anovosad/ambika-controller/hw/scheme.pdf

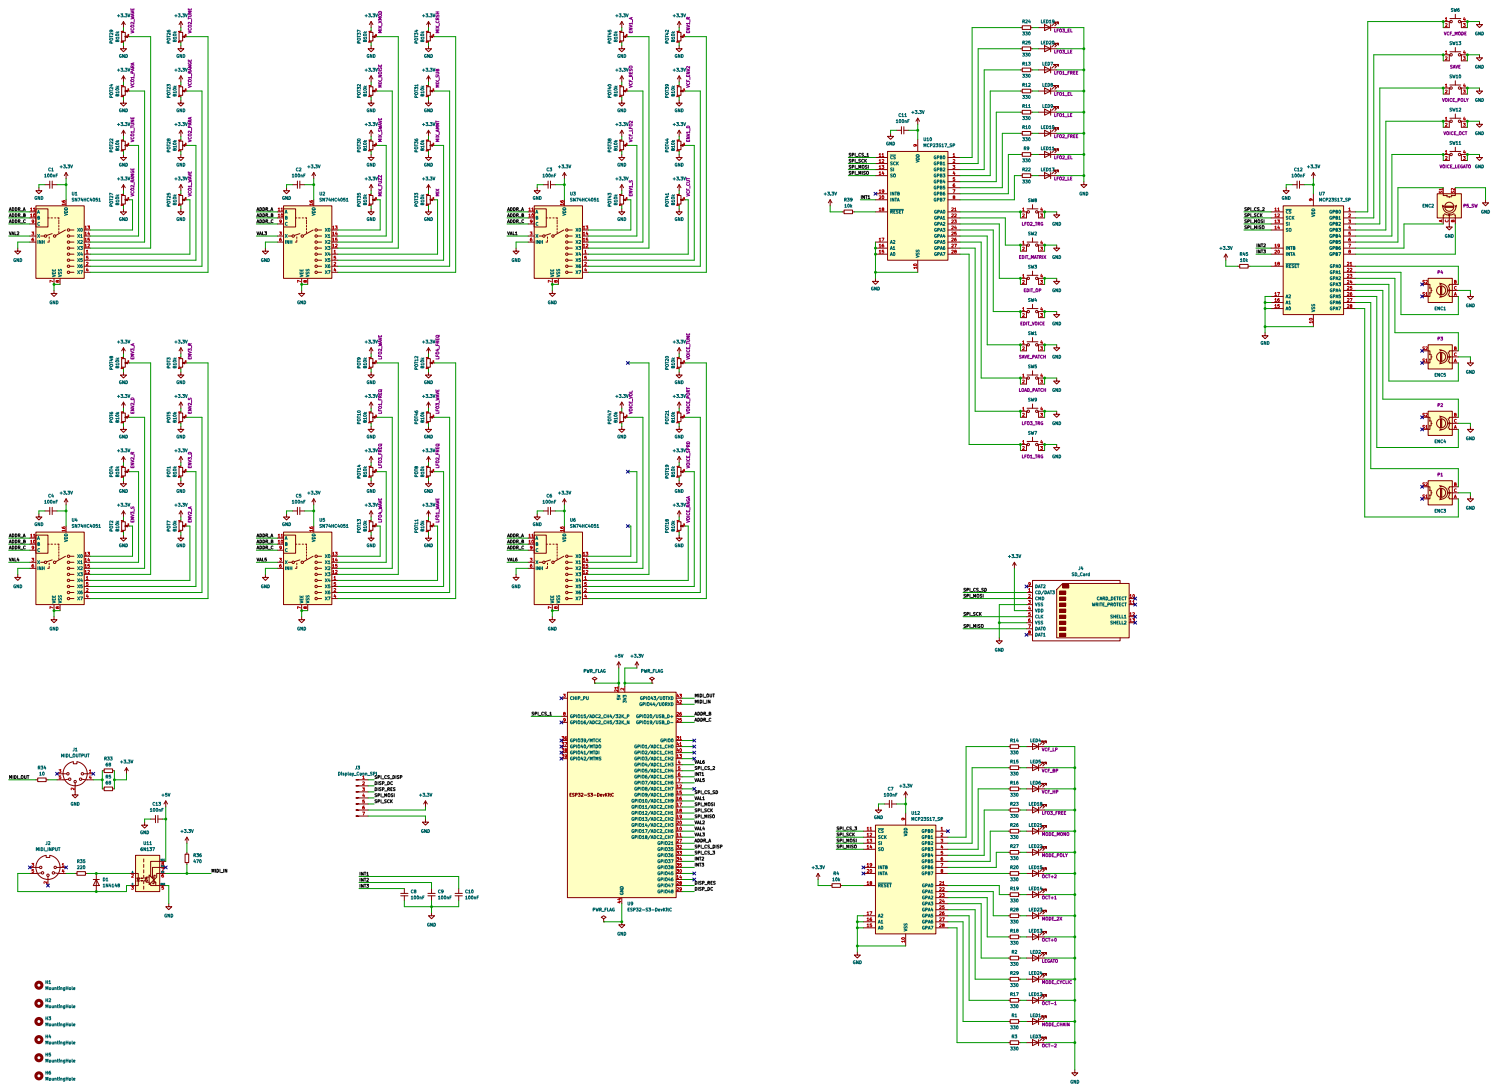
[picture p1: page 1]
