anovosad/ambika-controller/hw/kicad/ambika-controller.kicad_pcb

## KiCad design hw/kicad/ambika-controller.kicad_pcb (2024-06-11)

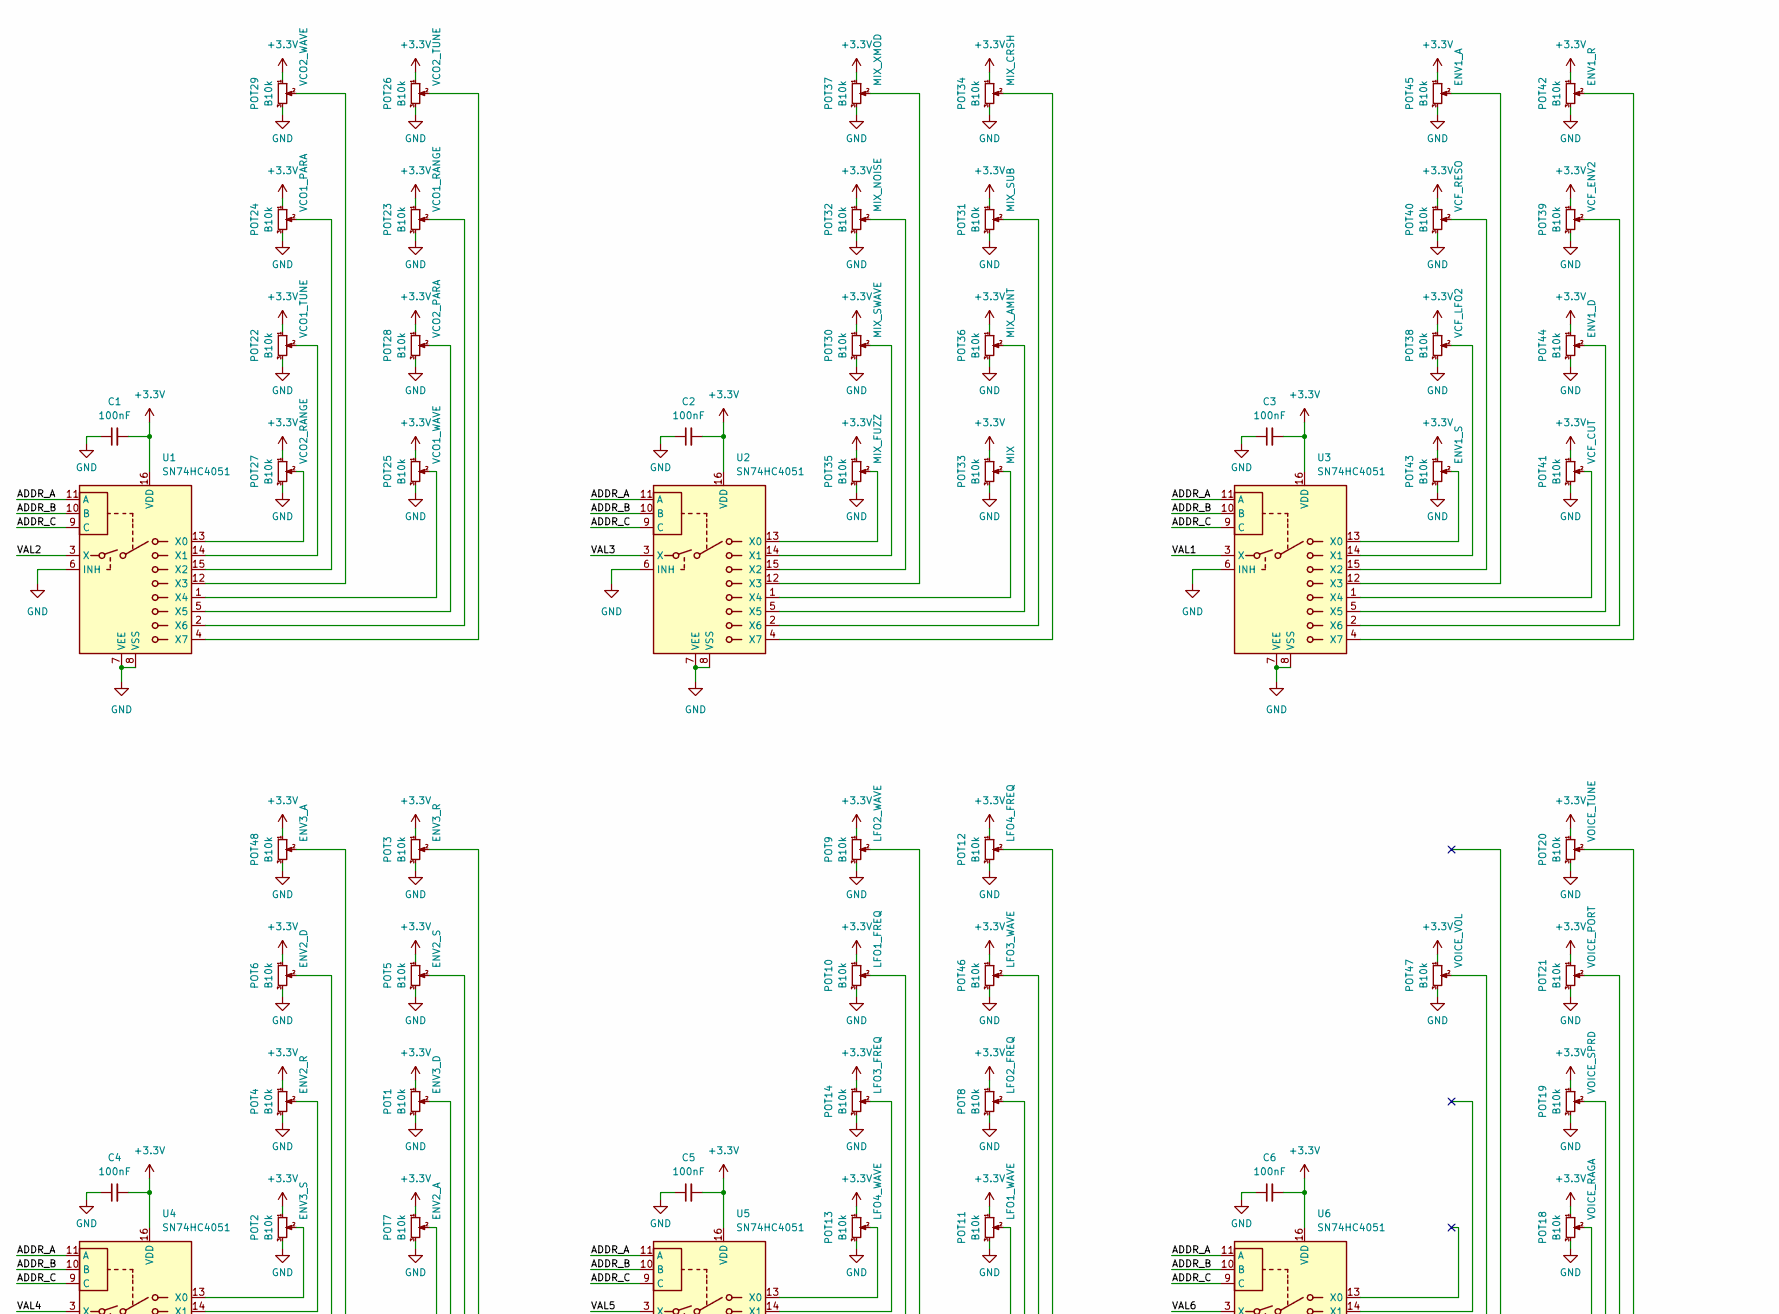
[picture p2: schematic ambika-controller.kicad_sch, Ambika Controller, part in row 1, column 1]

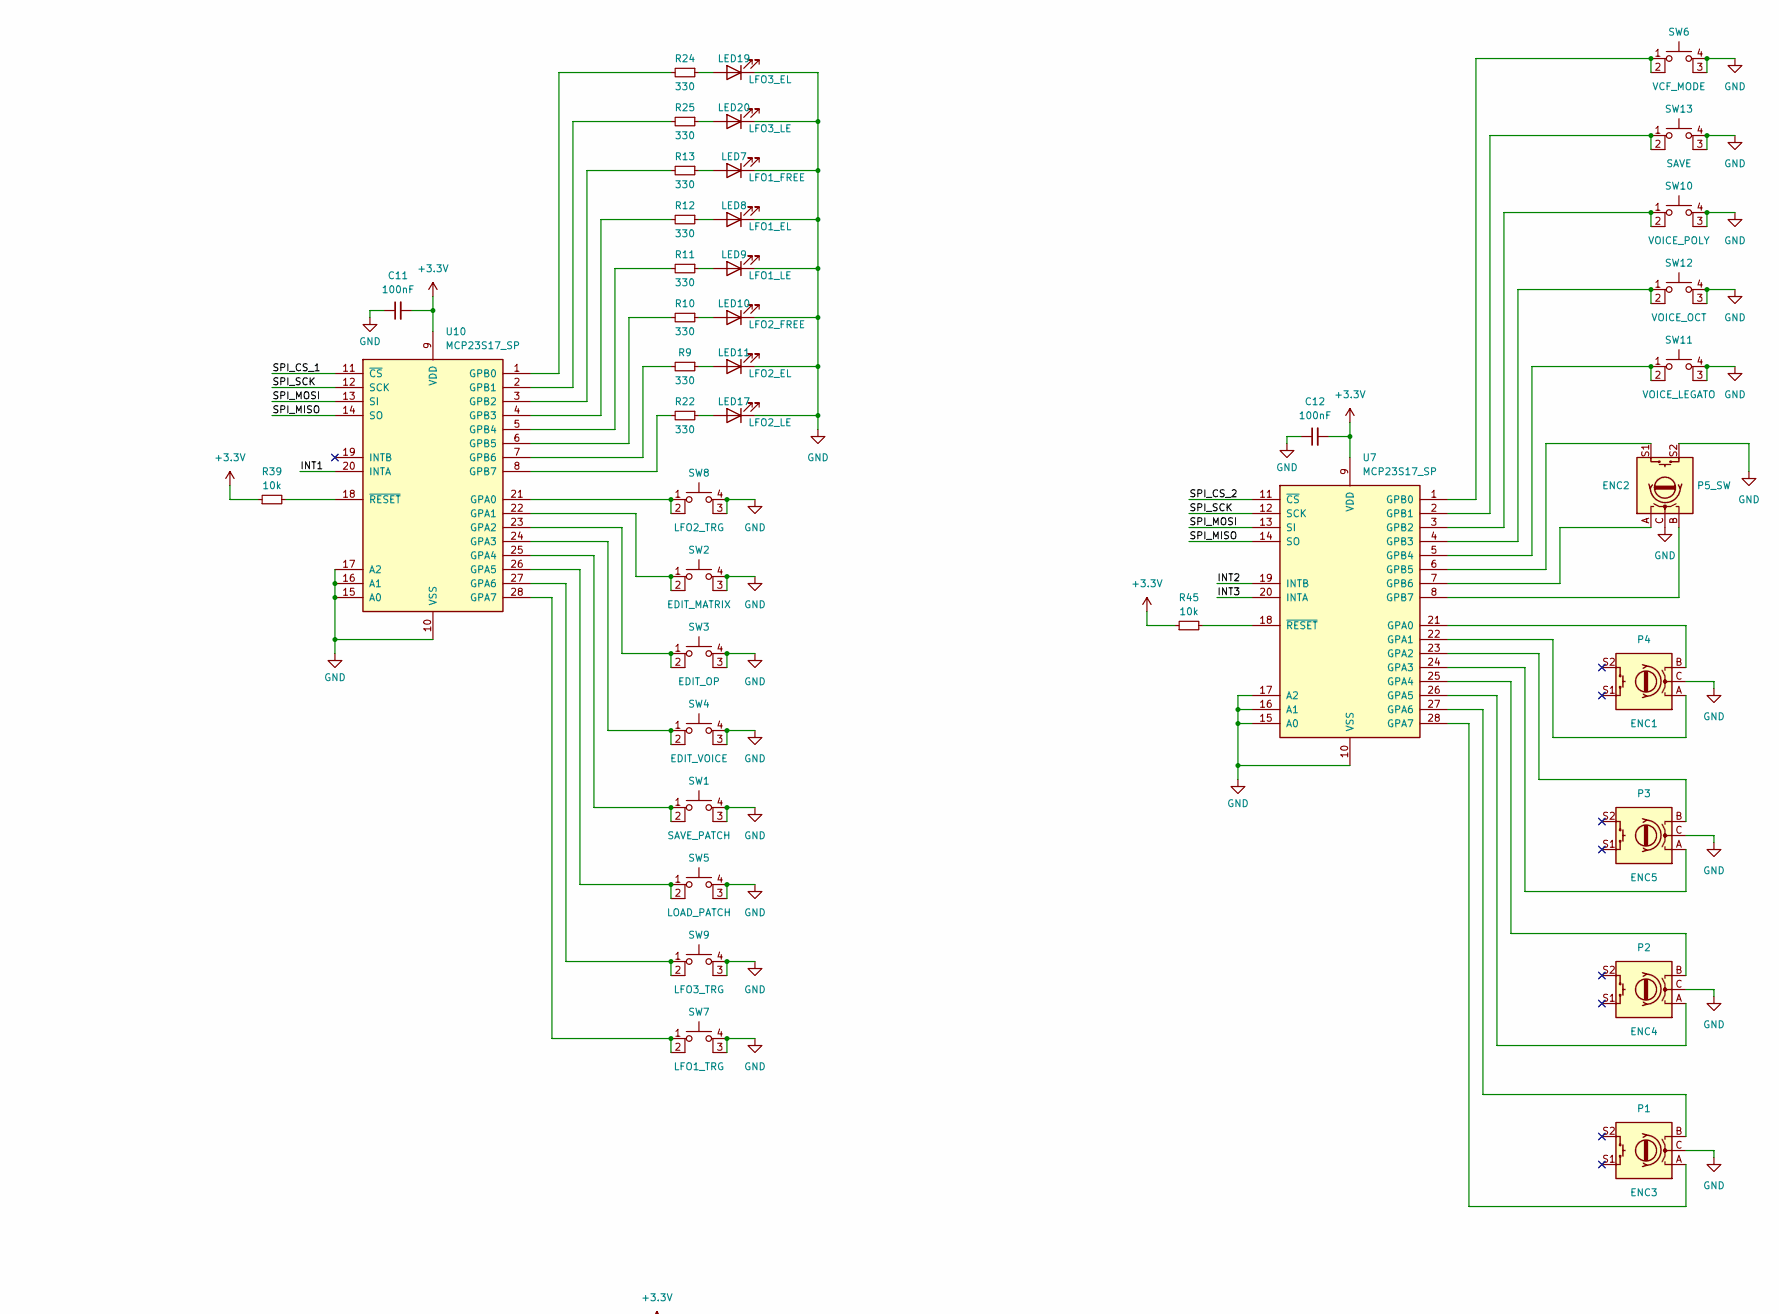
[picture p3: schematic ambika-controller.kicad_sch, Ambika Controller, part in row 1, column 2]

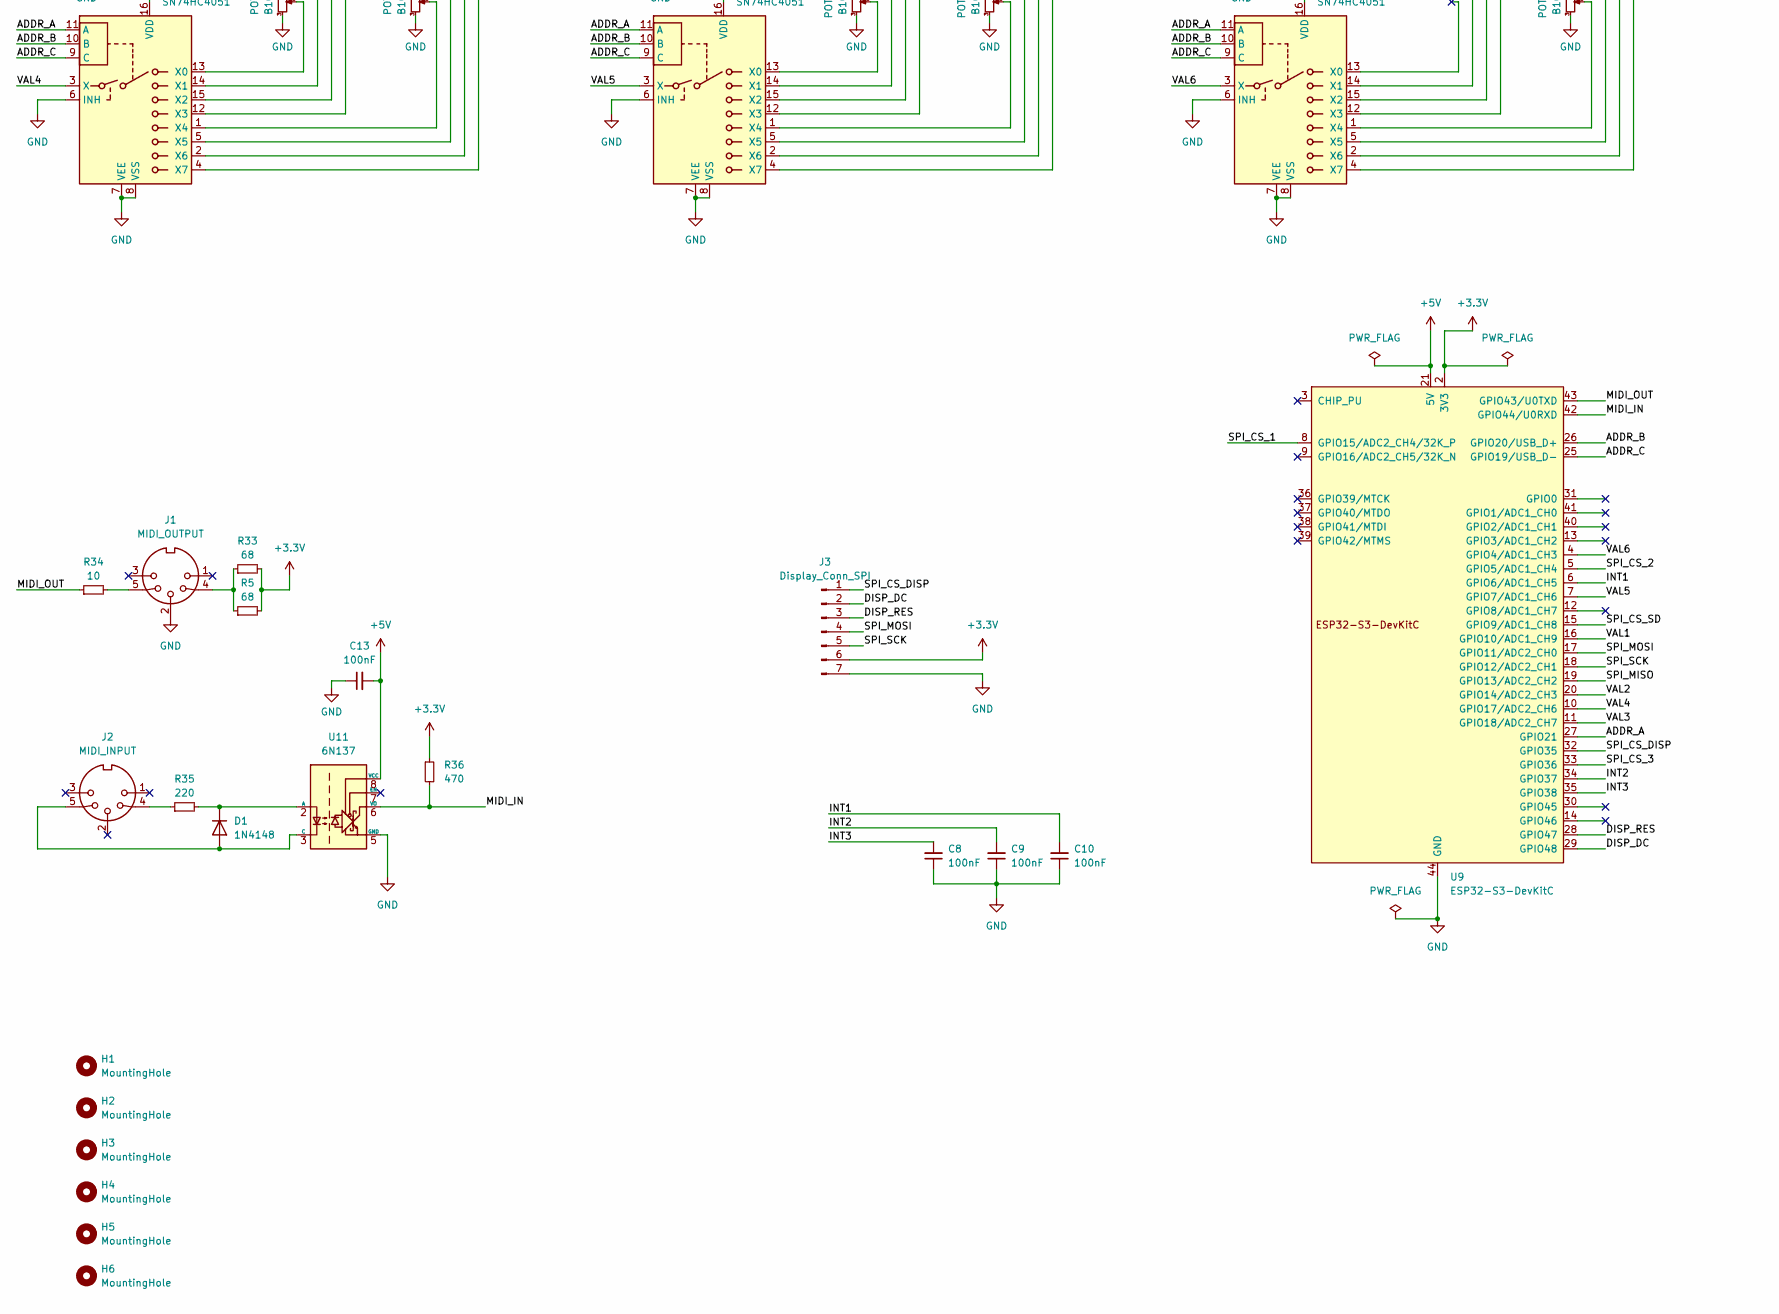
[picture p4: schematic ambika-controller.kicad_sch, Ambika Controller, part in row 2, column 1]

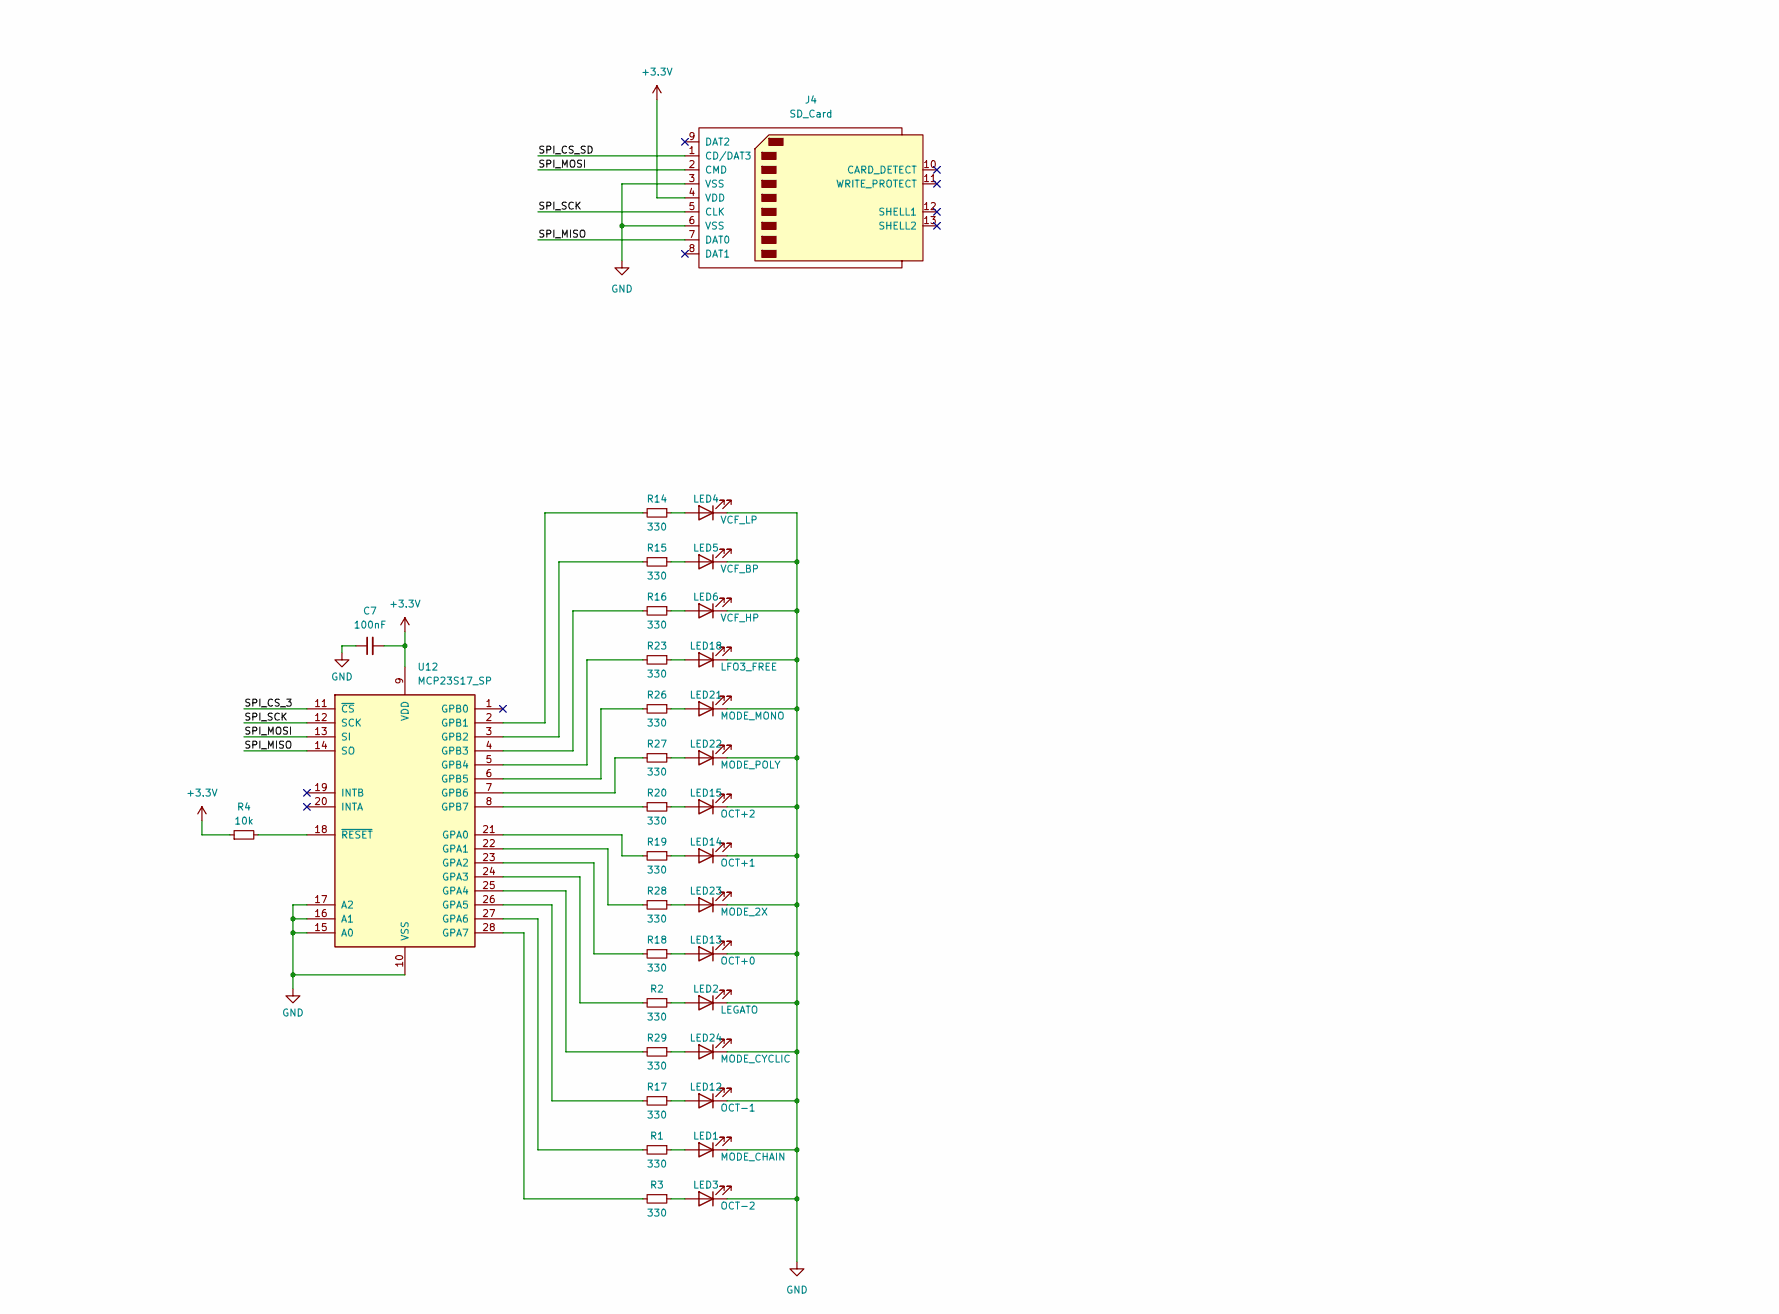
[picture p5: schematic ambika-controller.kicad_sch, Ambika Controller, part in row 2, column 2]

Parts:
C1, C2, C3, C4, C5, C6, C7, C8, C9, C10, C11, C12, C13: 100nF; C_Disc_D5.0mm_W2.5mm_P2.50mm
D1: 1N4148; D_DO-35_SOD27_P7.62mm_Horizontal
ENC1, ENC2, ENC3, ENC4, ENC5: ROTARY_ENCODER; RotaryEncoder_Alps_EC12E-Switch_Vertical_H20mm
H1, H2, H3, H4, H5, H6: MountingHole; MountingHole_3.2mm_M3_DIN965_Pad_TopBottom
J1: MIDI_OUTPUT; MIDI_DIN5
J2: MIDI_INPUT; MIDI_DIN5
J3: Display_Conn_SPI; PinHeader_1x07_P2.54mm_Vertical
J4: SD_Card; SD_Kyocera_145638009511859+
LED1, LED2, LED3, LED4, LED5, LED6, LED7, LED8, LED9, LED10, LED11, LED12, LED13, LED14, LED15, LED17, LED18, LED19, LED20, LED21, LED22, LED23, LED24: GREEN; LED_D3.0mm
POT1, POT2, POT3, POT4, POT5, POT6, POT7, POT8, POT9, POT10, POT11, POT12, POT13, POT14, POT18, POT19, POT20, POT21, POT22, POT23, POT24, POT25, POT26, POT27, POT28, POT29, POT30, POT31, POT32, POT33, POT34, POT35, POT36, POT37, POT38, POT39, POT40, POT41, POT42, POT43, POT44, POT45, POT46, POT47, POT48: B10k; Potentiometer_Alpha_RD901F-40-00D_Single_Vertical
R1, R2, R3, R9, R10, R11, R12, R13, R14, R15, R16, R17, R18, R19, R20, R22, R23, R24, R25, R26, R27, R28, R29: 330; R_Axial_DIN0207_L6.3mm_D2.5mm_P7.62mm_Horizontal
R4, R39, R45: 10k; R_Axial_DIN0207_L6.3mm_D2.5mm_P7.62mm_Horizontal
R5, R33: 68; R_Axial_DIN0207_L6.3mm_D2.5mm_P7.62mm_Horizontal
R34: 10; R_Axial_DIN0207_L6.3mm_D2.5mm_P7.62mm_Horizontal
R35: 220; R_Axial_DIN0207_L6.3mm_D2.5mm_P7.62mm_Horizontal
R36: 470; R_Axial_DIN0207_L6.3mm_D2.5mm_P7.62mm_Horizontal
SW1, SW2, SW3, SW4, SW5, SW6, SW7, SW8, SW9, SW10, SW11, SW12, SW13: SW_PUSH-12mm-4pin
U1, U2, U3, U4, U5, U6: SN74HC4051; DIP-16_W7.62mm_Socket_LongPads
U7, U10, U12: MCP23S17_SP; DIP-28_W7.62mm
U9: ESP32-S3-DevKitC; Waveshare ESP32-S3-DevKitC
U11: 6N137; DIP-8_W7.62mm

Connections:
+3.3V: C1.2, C2.2, C3.2, C4.2, C5.2, C6.2, C7.2, C11.2, C12.2, J3.6, J4.4 (VDD), POT1.1, POT2.1, POT3.1, POT4.1, POT5.1, POT6.1, POT7.1, POT8.1, POT9.1, POT10.1, POT11.1, POT12.1, POT13.1, POT14.1, POT18.1, POT19.1, POT20.1, POT21.1, POT22.1, POT23.1, POT24.1, POT25.1, POT26.1, POT27.1, POT28.1, POT29.1, POT30.1, POT31.1, POT32.1, POT33.1, POT34.1, POT35.1, POT36.1, POT37.1, POT38.1, POT39.1, POT40.1, POT41.1, POT42.1, POT43.1, POT44.1, POT45.1, POT46.1, POT47.1, POT48.1, R4.1, R5.2, R33.2, R36.1, R39.1, R45.1, U1.16 (VDD), U2.16 (VDD), U3.16 (VDD), U4.16 (VDD), U5.16 (VDD), U6.16 (VDD), U7.9 (VDD), U9.1 (3V3), U9.2 (3V3), U10.9 (VDD), U12.9 (VDD)
+5V: C13.2, U9.21 (5V), U11.8 (VCC)
/ADDR_A: U1.11 (A), U2.11 (A), U3.11 (A), U4.11 (A), U5.11 (A), U6.11 (A), U9.27 (GPIO21)
/ADDR_B: U1.10 (B), U2.10 (B), U3.10 (B), U4.10 (B), U5.10 (B), U6.10 (B), U9.26 (GPIO20/USB_D+)
/ADDR_C: U1.9 (C), U2.9 (C), U3.9 (C), U4.9 (C), U5.9 (C), U6.9 (C), U9.25 (GPIO19/USB_D-)
/DISP_DC: J3.2, U9.29 (GPIO48)
/DISP_RES: J3.3, U9.28 (GPIO47)
/INT1: C10.2, U9.6 (GPIO6/ADC1_CH5), U10.20 (INTA)
/INT2: C9.2, U7.19 (INTB), U9.34 (GPIO37)
/INT3: C8.2, U7.20 (INTA), U9.35 (GPIO38)
/MIDI_IN: R36.2, U9.42 (GPIO44/U0RXD), U11.6 (VO)
/MIDI_OUT: R34.1, U9.43 (GPIO43/U0TXD)
/SPI_CS_1: U9.8 (GPIO15/ADC2_CH4/32K_P), U10.11 (~CS)
/SPI_CS_2: U7.11 (~CS), U9.5 (GPIO5/ADC1_CH4)
/SPI_CS_3: U9.33 (GPIO36), U12.11 (~CS)
/SPI_CS_DISP: J3.1, U9.32 (GPIO35)
/SPI_CS_SD: J4.1 (CD/DAT3), U9.15 (GPIO9/ADC1_CH8)
/SPI_MISO: J4.7 (DAT0), U7.14 (SO), U9.19 (GPIO13/ADC2_CH2), U10.14 (SO), U12.14 (SO)
/SPI_MOSI: J3.4, J4.2 (CMD), U7.13 (SI), U9.17 (GPIO11/ADC2_CH0), U10.13 (SI), U12.13 (SI)
/SPI_SCK: J3.5, J4.5 (CLK), U7.12 (SCK), U9.18 (GPIO12/ADC2_CH1), U10.12 (SCK), U12.12 (SCK)
/VAL1: U3.3 (X), U9.16 (GPIO10/ADC1_CH9)
/VAL2: U1.3 (X), U9.20 (GPIO14/ADC2_CH3)
/VAL3: U2.3 (X), U9.11 (GPIO18/ADC2_CH7)
/VAL4: U4.3 (X), U9.10 (GPIO17/ADC2_CH6)
/VAL5: U5.3 (X), U9.7 (GPIO7/ADC1_CH6)
/VAL6: U6.3 (X), U9.4 (GPIO4/ADC1_CH3)
GND: C1.1, C2.1, C3.1, C4.1, C5.1, C6.1, C7.1, C8.1, C9.1, C10.1, C11.1, C12.1, C13.1, ENC1.C, ENC2.C, ENC2.S2, ENC3.C, ENC4.C, ENC5.C, J1.2, J3.7, J4.3 (VSS), J4.6 (VSS), LED1.1 (K), LED2.1 (K), LED3.1 (K), LED4.1 (K), LED5.1 (K), LED6.1 (K), LED7.1 (K), LED8.1 (K), LED9.1 (K), LED10.1 (K), LED11.1 (K), LED12.1 (K), LED13.1 (K), LED14.1 (K), LED15.1 (K), LED17.1 (K), LED18.1 (K), LED19.1 (K), LED20.1 (K), LED21.1 (K), LED22.1 (K), LED23.1 (K), LED24.1 (K), POT1.3, POT2.3, POT3.3, POT4.3, POT5.3, POT6.3, POT7.3, POT8.3, POT9.3, POT10.3, POT11.3, POT12.3, POT13.3, POT14.3, POT18.3, POT19.3, POT20.3, POT21.3, POT22.3, POT23.3, POT24.3, POT25.3, POT26.3, POT27.3, POT28.3, POT29.3, POT30.3, POT31.3, POT32.3, POT33.3, POT34.3, POT35.3, POT36.3, POT37.3, POT38.3, POT39.3, POT40.3, POT41.3, POT42.3, POT43.3, POT44.3, POT45.3, POT46.3, POT47.3, POT48.3, SW1.3 (K), SW1.4 (A), SW2.3 (K), SW2.4 (A), SW3.3 (K), SW3.4 (A), SW4.3 (K), SW4.4 (A), SW5.3 (K), SW5.4 (A), SW6.3 (K), SW6.4 (A), SW7.3 (K), SW7.4 (A), SW8.3 (K), SW8.4 (A), SW9.3 (K), SW9.4 (A), SW10.3 (K), SW10.4 (A), SW11.3 (K), SW11.4 (A), SW12.3 (K), SW12.4 (A), SW13.3 (K), SW13.4 (A), U1.6 (INH), U1.7 (VEE), U1.8 (VSS), U2.6 (INH), U2.7 (VEE), U2.8 (VSS), U3.6 (INH), U3.7 (VEE), U3.8 (VSS), U4.6 (INH), U4.7 (VEE), U4.8 (VSS), U5.6 (INH), U5.7 (VEE), U5.8 (VSS), U6.6 (INH), U6.7 (VEE), U6.8 (VSS), U7.10 (VSS), U7.15 (A0), U7.16 (A1), U7.17 (A2), U9.22 (GND), U9.23 (GND), U9.24 (GND), U9.44 (GND), U10.10 (VSS), U10.15 (A0), U10.16 (A1), U10.17 (A2), U11.5 (GND), U12.10 (VSS), U12.15 (A0), U12.16 (A1), U12.17 (A2)
unnamed: D1.2 (A), J2.5, U11.3 (C)
unnamed: D1.1 (K), R35.2, U11.2 (A)
unnamed: J1.4, R5.1, R33.1
unnamed: J1.5, R34.2
unnamed: J2.4, R35.1
unnamed: LED1.2 (A), R1.1
unnamed: LED2.2 (A), R2.1
unnamed: LED3.2 (A), R3.1
unnamed: LED4.2 (A), R14.1
unnamed: LED5.2 (A), R15.1
unnamed: LED6.2 (A), R16.1
unnamed: LED7.2 (A), R13.1
unnamed: LED8.2 (A), R12.1
unnamed: LED9.2 (A), R11.1
unnamed: LED10.2 (A), R10.1
unnamed: LED11.2 (A), R9.1
unnamed: LED12.2 (A), R17.1
unnamed: LED13.2 (A), R18.1
unnamed: LED14.2 (A), R19.1
unnamed: LED15.2 (A), R20.1
unnamed: LED17.2 (A), R22.1
unnamed: LED18.2 (A), R23.1
unnamed: LED19.2 (A), R24.1
unnamed: LED20.2 (A), R25.1
unnamed: LED21.2 (A), R26.1
unnamed: LED22.2 (A), R27.1
unnamed: LED23.2 (A), R28.1
unnamed: LED24.2 (A), R29.1
unnamed: POT27.2, U1.13 (X0)
unnamed: POT22.2, U1.14 (X1)
unnamed: POT24.2, U1.15 (X2)
unnamed: POT29.2, U1.12 (X3)
unnamed: POT25.2, U1.1 (X4)
unnamed: POT28.2, U1.5 (X5)
unnamed: POT23.2, U1.2 (X6)
unnamed: POT26.2, U1.4 (X7)
unnamed: POT35.2, U2.13 (X0)
unnamed: POT30.2, U2.14 (X1)
unnamed: POT32.2, U2.15 (X2)
unnamed: POT37.2, U2.12 (X3)
unnamed: POT33.2, U2.1 (X4)
unnamed: POT36.2, U2.5 (X5)
unnamed: POT31.2, U2.2 (X6)
unnamed: POT34.2, U2.4 (X7)
unnamed: POT43.2, U3.13 (X0)
unnamed: POT38.2, U3.14 (X1)
unnamed: POT40.2, U3.15 (X2)
unnamed: POT45.2, U3.12 (X3)
unnamed: POT41.2, U3.1 (X4)
unnamed: POT44.2, U3.5 (X5)
unnamed: POT39.2, U3.2 (X6)
unnamed: POT42.2, U3.4 (X7)
unnamed: POT2.2, U4.13 (X0)
unnamed: POT4.2, U4.14 (X1)
unnamed: POT6.2, U4.15 (X2)
unnamed: POT48.2, U4.12 (X3)
unnamed: POT7.2, U4.1 (X4)
unnamed: POT1.2, U4.5 (X5)
unnamed: POT5.2, U4.2 (X6)
unnamed: POT3.2, U4.4 (X7)
unnamed: POT13.2, U5.13 (X0)
unnamed: POT14.2, U5.14 (X1)
unnamed: POT10.2, U5.15 (X2)
unnamed: POT9.2, U5.12 (X3)
unnamed: POT11.2, U5.1 (X4)
unnamed: POT8.2, U5.5 (X5)
unnamed: POT46.2, U5.2 (X6)
unnamed: POT12.2, U5.4 (X7)
unnamed: POT47.2, U6.15 (X2)
unnamed: POT18.2, U6.1 (X4)
unnamed: POT19.2, U6.5 (X5)
unnamed: POT21.2, U6.2 (X6)
unnamed: POT20.2, U6.4 (X7)
unnamed: ENC1.B, U7.21 (GPA0)
unnamed: ENC1.A, U7.22 (GPA1)
unnamed: ENC5.B, U7.23 (GPA2)
unnamed: ENC5.A, U7.24 (GPA3)
unnamed: ENC4.B, U7.25 (GPA4)
unnamed: ENC4.A, U7.26 (GPA5)
unnamed: ENC3.B, U7.27 (GPA6)
unnamed: ENC3.A, U7.28 (GPA7)
unnamed: SW6.1, SW6.2, U7.1 (GPB0)
unnamed: SW13.1, SW13.2, U7.2 (GPB1)
unnamed: SW10.1, SW10.2, U7.3 (GPB2)
unnamed: SW12.1, SW12.2, U7.4 (GPB3)
unnamed: SW11.1, SW11.2, U7.5 (GPB4)
unnamed: ENC2.S1, U7.6 (GPB5)
unnamed: ENC2.A, U7.7 (GPB6)
unnamed: ENC2.B, U7.8 (GPB7)
unnamed: R45.2, U7.18 (~RESET)
unnamed: SW8.1, SW8.2, U10.21 (GPA0)
unnamed: SW2.1, SW2.2, U10.22 (GPA1)
unnamed: SW3.1, SW3.2, U10.23 (GPA2)
unnamed: SW4.1, SW4.2, U10.24 (GPA3)
unnamed: SW1.1, SW1.2, U10.25 (GPA4)
unnamed: SW5.1, SW5.2, U10.26 (GPA5)
unnamed: SW9.1, SW9.2, U10.27 (GPA6)
unnamed: SW7.1, SW7.2, U10.28 (GPA7)
unnamed: R24.2, U10.1 (GPB0)
unnamed: R25.2, U10.2 (GPB1)
unnamed: R13.2, U10.3 (GPB2)
unnamed: R12.2, U10.4 (GPB3)
unnamed: R11.2, U10.5 (GPB4)
unnamed: R10.2, U10.6 (GPB5)
unnamed: R9.2, U10.7 (GPB6)
unnamed: R22.2, U10.8 (GPB7)
unnamed: R39.2, U10.18 (~RESET)
unnamed: R19.2, U12.21 (GPA0)
unnamed: R28.2, U12.22 (GPA1)
unnamed: R18.2, U12.23 (GPA2)
unnamed: R2.2, U12.24 (GPA3)
unnamed: R29.2, U12.25 (GPA4)
unnamed: R17.2, U12.26 (GPA5)
unnamed: R1.2, U12.27 (GPA6)
unnamed: R3.2, U12.28 (GPA7)
unnamed: R14.2, U12.2 (GPB1)
unnamed: R15.2, U12.3 (GPB2)
unnamed: R16.2, U12.4 (GPB3)
unnamed: R23.2, U12.5 (GPB4)
unnamed: R26.2, U12.6 (GPB5)
unnamed: R27.2, U12.7 (GPB6)
unnamed: R20.2, U12.8 (GPB7)
unnamed: R4.2, U12.18 (~RESET)

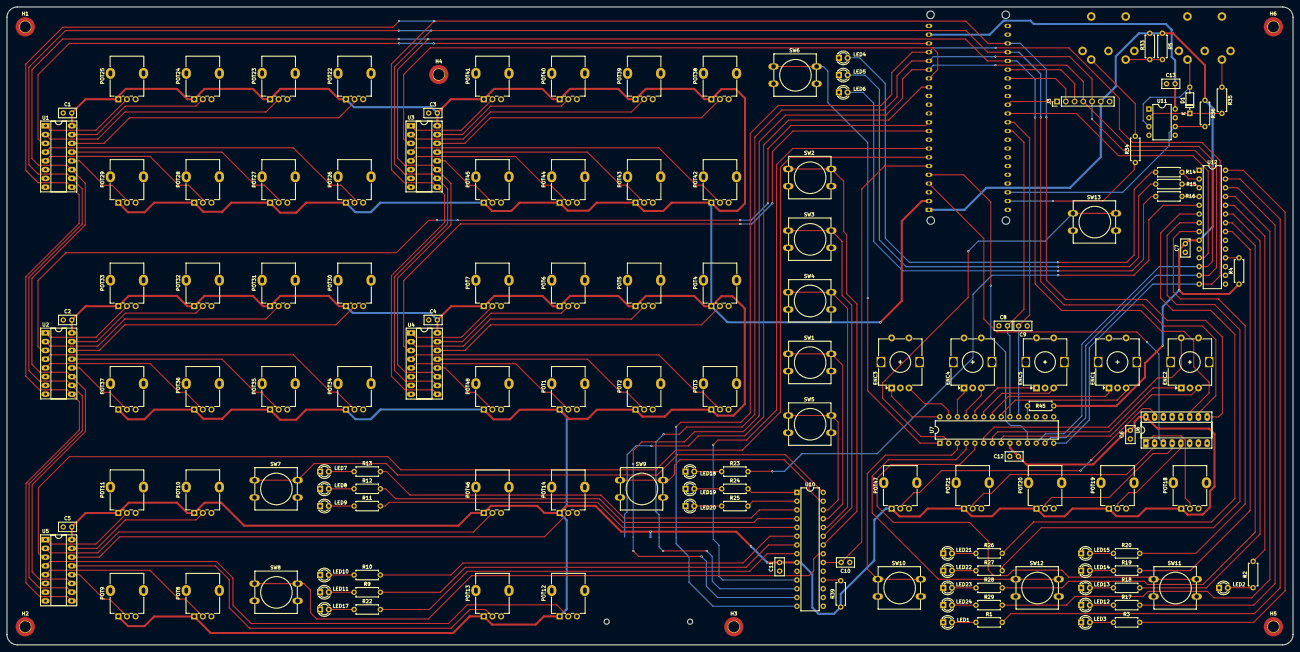
[picture p6: board ambika-controller.kicad_pcb from above]

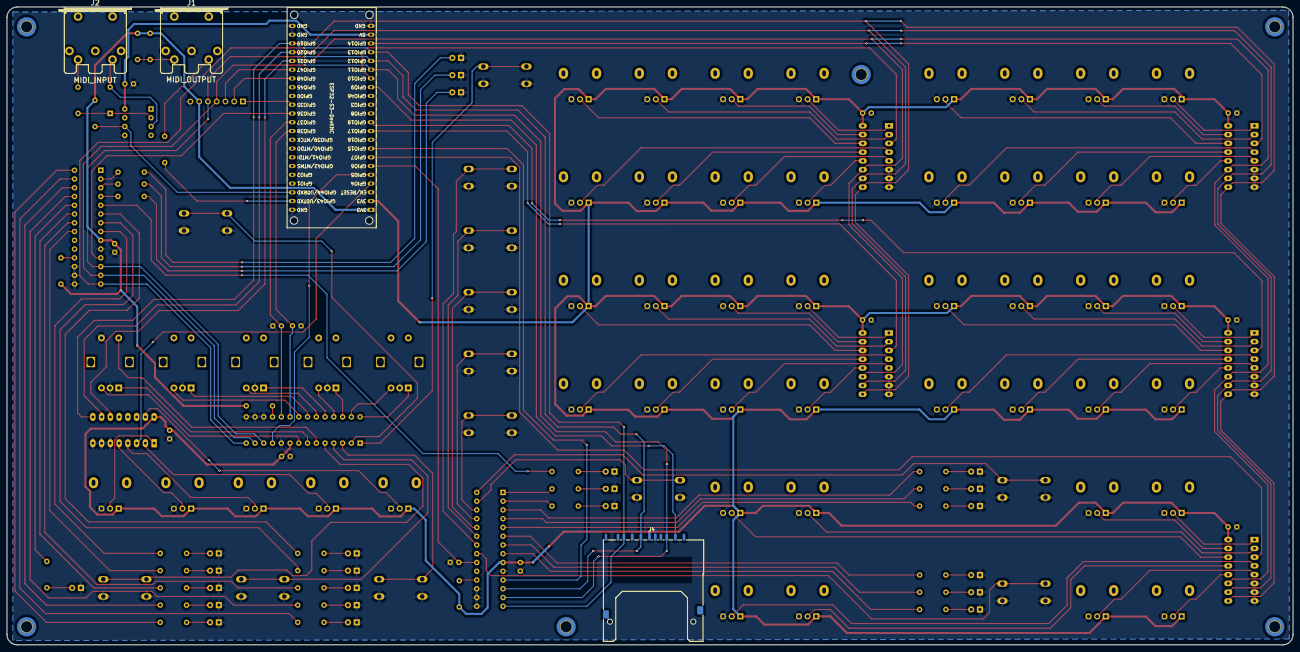
[picture p7: board ambika-controller.kicad_pcb from below]

Board: 2 copper layers, 373.0 x 185.0 mm, 152 parts (4 on the bottom side), 150 nets.
