anovosad/ambika-controller/src/pins.h

#pragma once

#define PIN_VAL1 10 
#define PIN_VAL2 14
#define PIN_VAL3 18
#define PIN_VAL4 17
#define PIN_VAL5 7
#define PIN_VAL6 4

#define PIN_ADDR_A 21
#define PIN_ADDR_B 20
#define PIN_ADDR_C 19

#define PIN_MCP1_CS 15
#define PIN_MCP2_CS 5
#define PIN_MCP3_CS 36

#define PIN_MCP_INT1 6
#define PIN_MCP_INT2 37
#define PIN_MCP_INT3 38

#define PIN_LED_VCF_LP 9
#define PIN_LED_VCF_BP 10
#define PIN_LED_VCF_HP 11

#define PIN_LED_OCT_PLUS2 15
#define PIN_LED_OCT_PLUS1 0
#define PIN_LED_OCT_0 2
#define PIN_LED_OCT_MINUS1 5
#define PIN_LED_OCT_MINUS2 7

#define PIN_LED_MODE_MONO 13
#define PIN_LED_MODE_POLY 14
#define PIN_LED_MODE_2X 1
#define PIN_LED_MODE_CYCLIC 4
#define PIN_LED_MODE_CHAIN 6

#define PIN_LED_LFO1_FREE 10
#define PIN_LED_LFO1_EL 11
#define PIN_LED_LFO1_LE 12

#define PIN_LED_LFO2_FREE 13
#define PIN_LED_LFO2_EL 14
#define PIN_LED_LFO2_LE 15

#define PIN_LED_LFO3_FREE 12
#define PIN_LED_LFO3_EL 8
#define PIN_LED_LFO3_LE 9

#define PIN_LED_LEGATO 3

#define PIN_SW_VCF_MODE 8
#define PIN_SW_SAVE 9
#define PIN_SW_VOICE_POLY 10
#define PIN_SW_VOICE_OCT 11
#define PIN_SW_VOICE_LEGATO 12
#define PIN_SW_ENC5 13
#define PIN_SW_LFO2_TRG 0
#define PIN_SW_MAIN_PAGE 1
#define PIN_SW_EDIT_MATRIX_OP 2
#define PIN_SW_EDIT_VOICE 3
#define PIN_SW_LOAD_PATCH 4
#define PIN_SW_SAVE_PATCH 5
#define PIN_SW_LFO3_TRG 6
#define PIN_SW_LFO1_TRG 7

#define PIN_ENC1_CW 6
#define PIN_ENC1_CCW 7
#define PIN_ENC2_CW 4
#define PIN_ENC2_CCW 5
#define PIN_ENC3_CW 2
#define PIN_ENC3_CCW 3
#define PIN_ENC4_CW 0
#define PIN_ENC4_CCW 1
#define PIN_ENC5_CW 15
#define PIN_ENC5_CCW 14
#define PIN_ENC5_BTN 13
