anovosad/ambika-controller/(commit log)

2024-05-20 added kicad files
    [ambika-controller.kicad_pcb, ambika-controller.kicad_sch]
2024-06-11 change to esp32
    [ambika-controller.kicad_pcb, ambika-controller.kicad_sch]
2024-07-20 changed switches behaviour
